asavartsov/daisybox/DaisyBoard/DaisyInterconnect/DaisyInterconnect.step

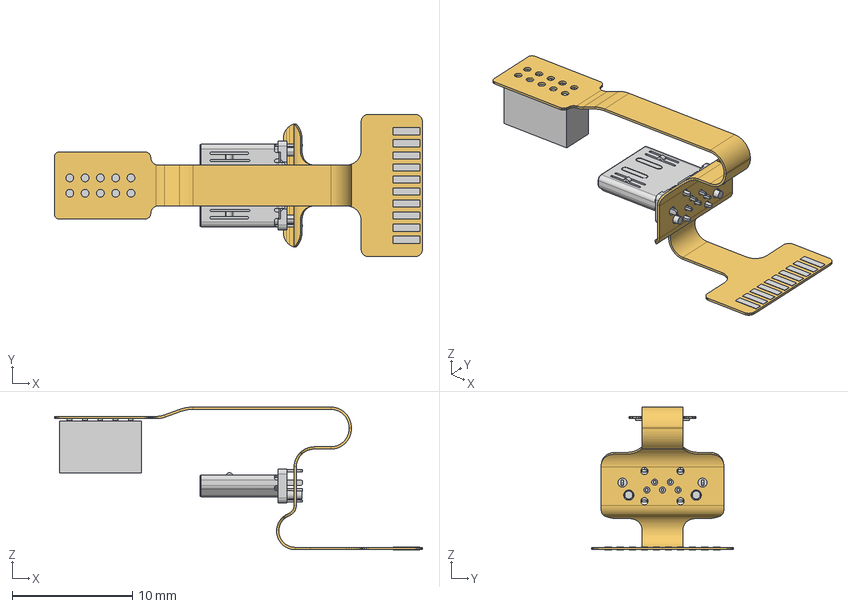
[picture p1: CAD file, 2023-12-05]
DaisyBoard/DaisyInterconnect/DaisyInterconnect.step
30.6 x 11.8 x 11.9 mm
Flex PCB
USB Plug
2x5 Socket
Pads
