asavartsov/daisybox/DaisyBoard/DaisyInterconnect/DaisyInterconnectBent.step

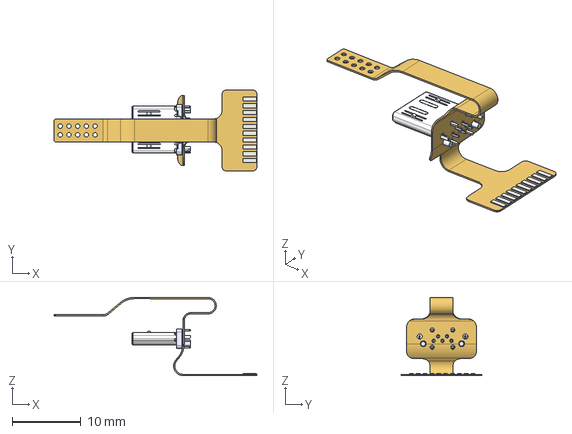
[picture p2: CAD file, 2023-12-05]
DaisyBoard/DaisyInterconnect/DaisyInterconnectBent.step
29.6 x 11.8 x 11.4 mm
_autosave-DaisyInterconnect PCB
