asavartsov/daisybox/DaisyBoard/DaisyInterconnect/DaisyInterconnectFlat.step

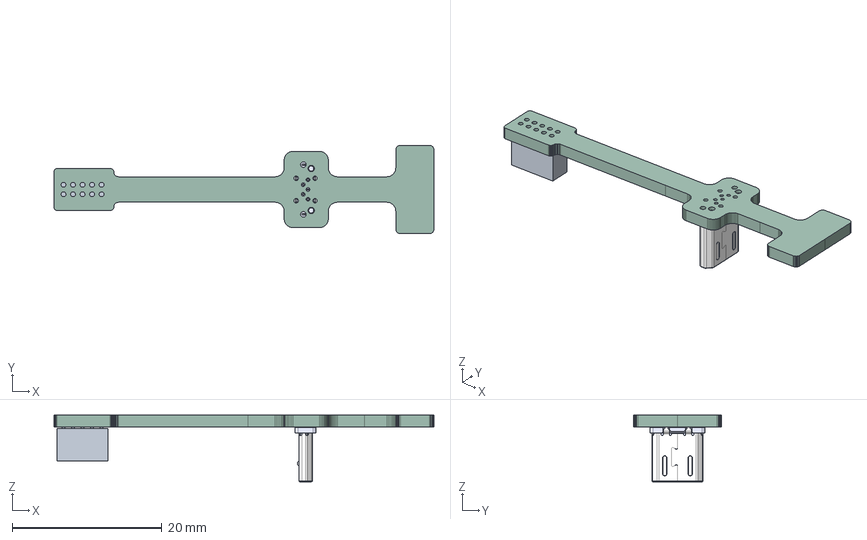
[picture p3: CAD file, 2023-12-05]
DaisyBoard/DaisyInterconnect/DaisyInterconnectFlat.step
50.7 x 11.8 x 8.88 mm
DaisyInterconnect PCB
