asavartsov/daisybox/Interconnect Flex Schematic.pdf

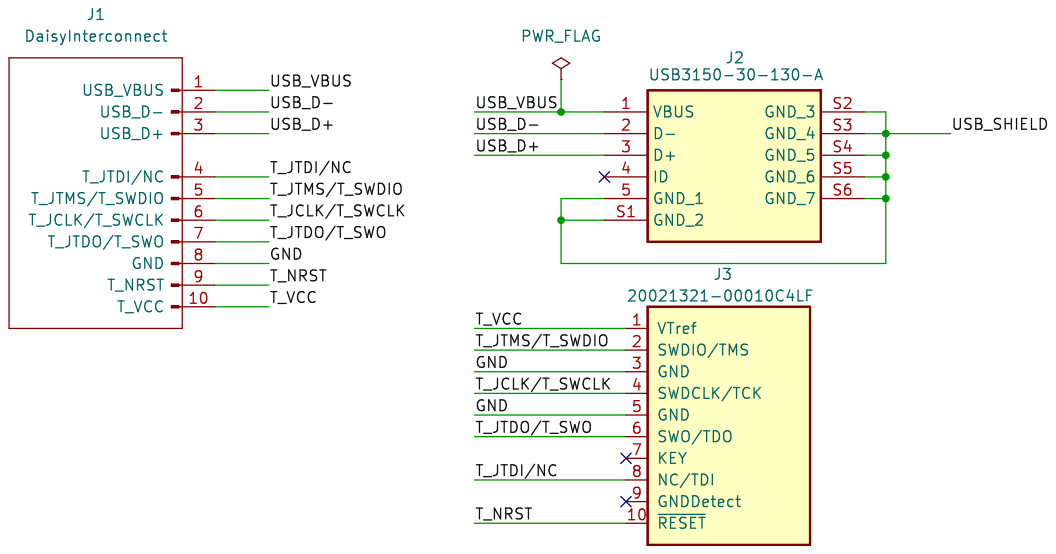
[picture p4: page 1]
