asavartsov/daisybox/Interconnect Flex PCB.pdf

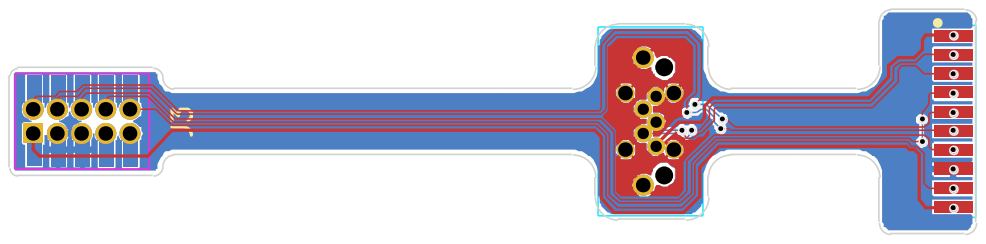
[picture p10: page 1]
