asavartsov/daisybox/PCB.pdf

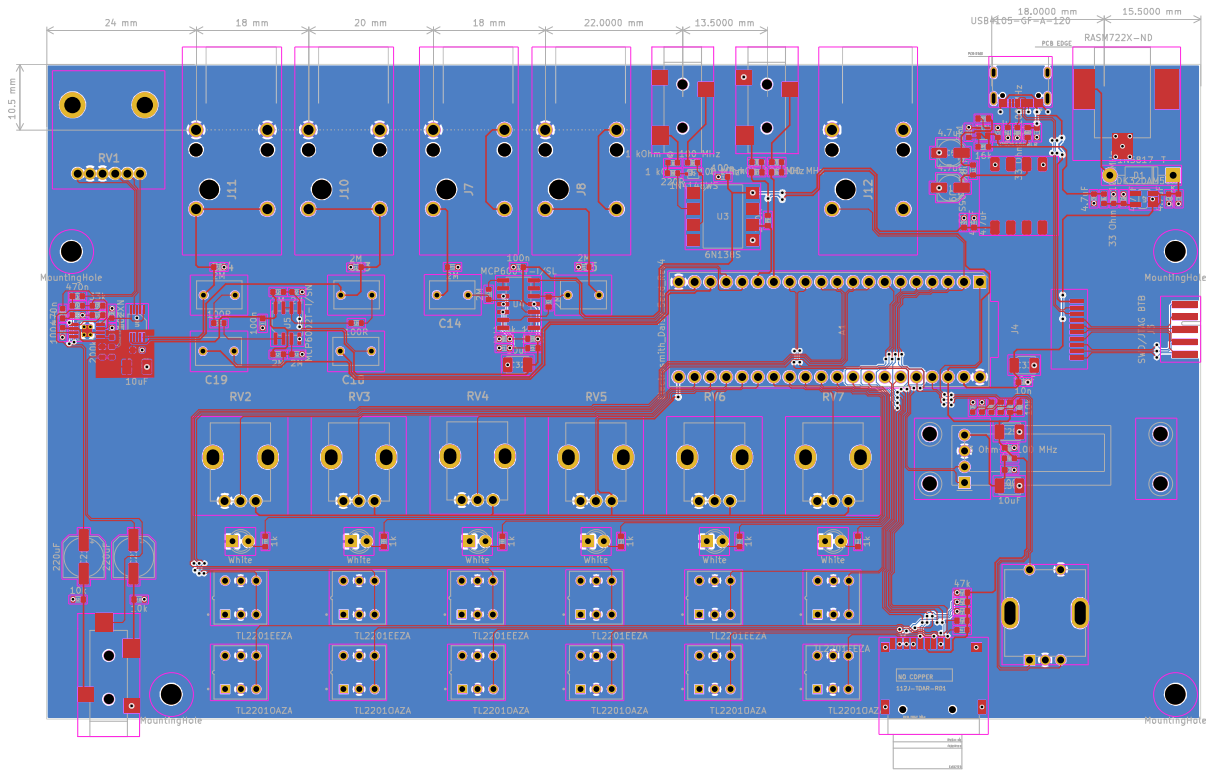
[picture p11: page 1]
