asavartsov/daisybox/DaisyBoard/DaisyInterconnect/DaisyInterconnect.kicad_pcb

## KiCad design DaisyBoard/DaisyInterconnect/DaisyInterconnect.kicad_pcb (2023-12-05)

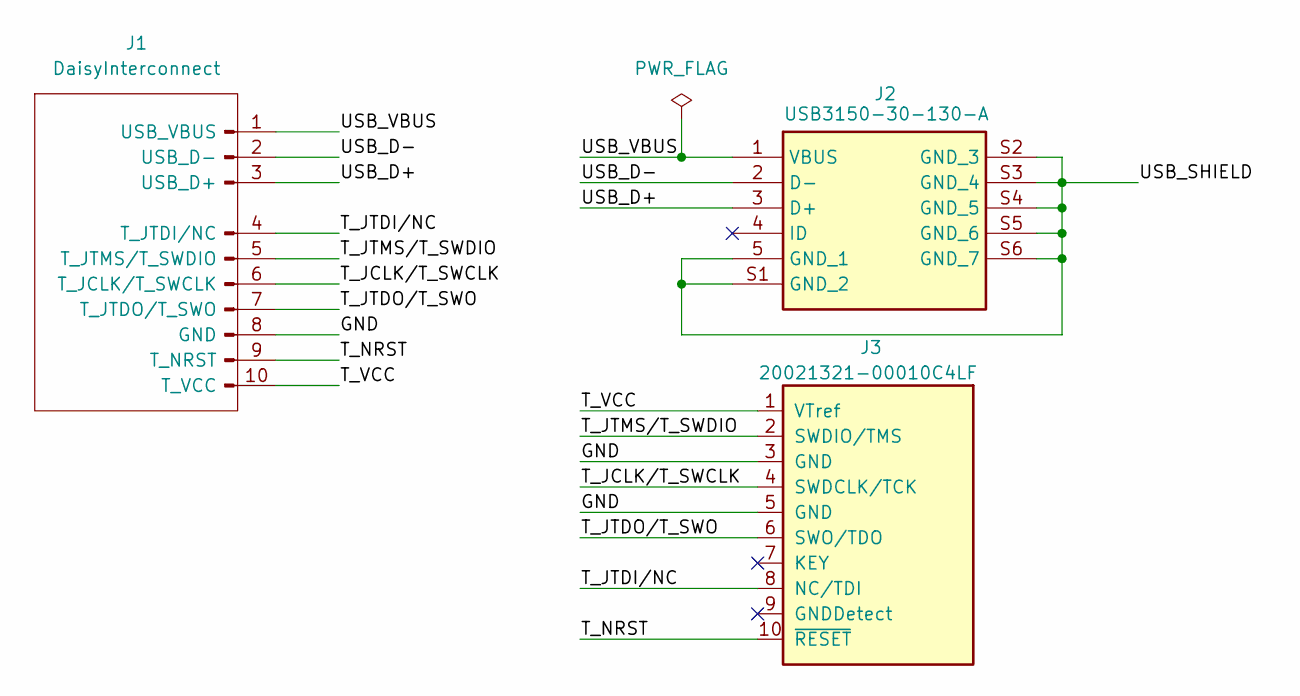
[picture p12: schematic DaisyInterconnect.kicad_sch]

Parts:
J1: DaisyInterconnect
J2: USB3150-30-130-A; USB315030130A; Manufacturer_Part_Number USB3150-30-130-A
J3: 20021321-00010C4LF; 2x05_P1.27mm; MPN 20021321-00010C4LF

Connections:
/GND: J1.8 (GND), J3.3 (GND), J3.5 (GND)
/T_JCLK/T_SWCLK: J1.6 (T_JCLK/T_SWCLK), J3.4 (SWDCLK/TCK)
/T_JTDI/NC: J1.4 (T_JTDI/NC), J3.8 (NC/TDI)
/T_JTDO/T_SWO: J1.7 (T_JTDO/T_SWO), J3.6 (SWO/TDO)
/T_JTMS/T_SWDIO: J1.5 (T_JTMS/T_SWDIO), J3.2 (SWDIO/TMS)
/T_NRST: J1.9 (T_NRST), J3.10 (~RESET)
/T_VCC: J1.10 (T_VCC), J3.1 (VTref)
/USB_D+: J1.3 (USB_D+), J2.3 (D+)
/USB_D-: J1.2 (USB_D-), J2.2 (D-)
/USB_SHIELD: J2.5 (GND_1), J2.S1 (GND_2), J2.S2 (GND_3), J2.S3 (GND_4), J2.S4 (GND_5), J2.S5 (GND_6), J2.S6 (GND_7)
/USB_VBUS: J1.1 (USB_VBUS), J2.1 (VBUS)

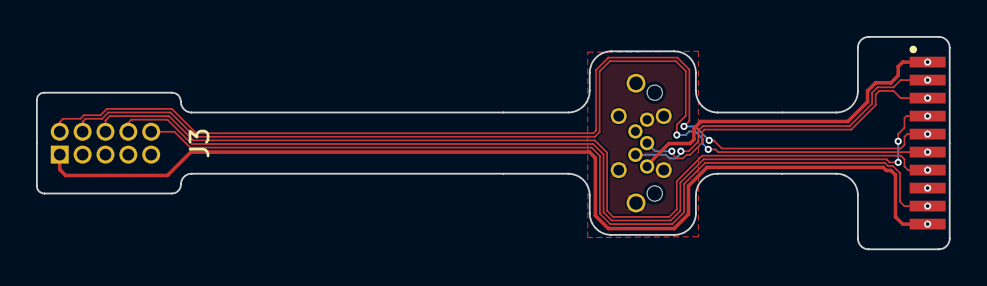
[picture p13: board DaisyInterconnect.kicad_pcb from above]

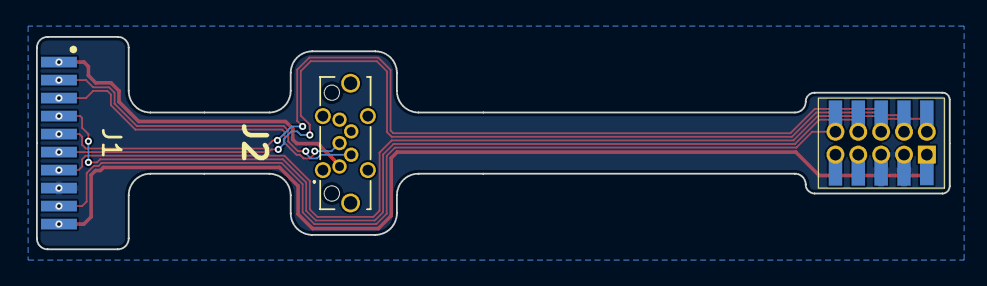
[picture p14: board DaisyInterconnect.kicad_pcb from below]

Board: 2 copper layers, 50.7 x 11.8 mm, 3 parts (2 on the bottom side), 11 nets.
