asavartsov/daisybox/DaisyBoard/DaisyBoard.kicad_pcb

## KiCad design DaisyBoard/DaisyBoard.kicad_pcb (2023-12-05)

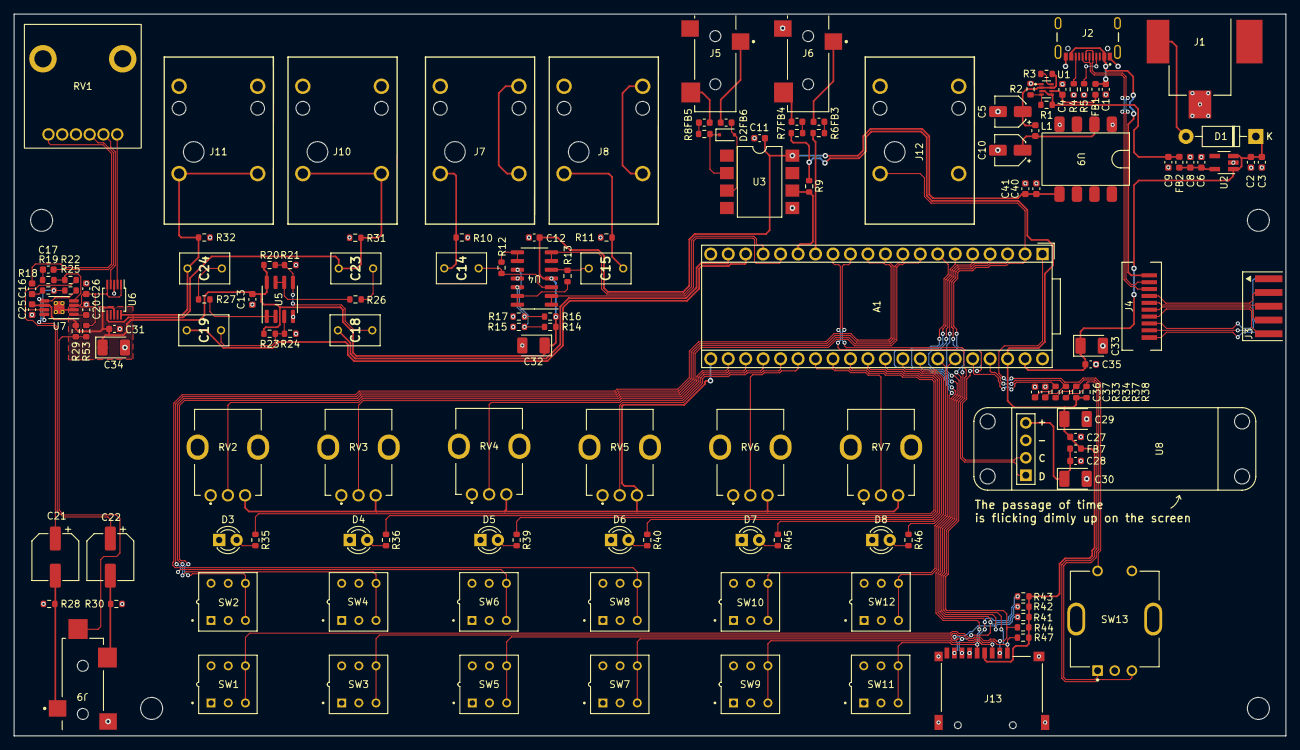
[picture p15: board DaisyBoard.kicad_pcb from above]

Board: 2 copper layers, 185.0 x 105.0 mm, 149 parts (0 on the bottom side), 111 nets.

Parts:
A1: Electrosmith_Daisy_Seed_Rev4; Electrosmith_Daisy_Seed
C1, C3, C8, C27, C35, C36, C37: 10n; C_0603_1608Metric
C2, C4, C6, C9, C40, C41: 4.7uF; C_0603_1608Metric
C5, C10: 4.7uF; CP_Elec_4x5.4
C11, C12, C13, C20, C25, C26, C28, C31: 100n; C_0603_1608Metric
C14, C15, C18, C19, C23, C24: 1uF; B32529C0105J189
C16, C17: 470n; C_0603_1608Metric
C21, C22: 220uF; CP_Elec_6.3x5.7
C29, C30, C32, C33, C34: 10uF; CP_EIA-3528-15_AVX-H_Pad1.50x2.35mm_HandSolder
D1: 1N5817-T; D_DO-41_SOD81_P10.16mm_Horizontal
D2: 1N4148WS; D_SOD-323F
D3, D4, D5, D6, D7, D8: White; QBL7IW60D-NW
FB1, FB2, FB7: 33 Ohm @ 100 MHz; L_0603_1608Metric
FB3, FB4, FB5, FB6: 1 kOhm @ 100 MHz; L_0603_1608Metric
H1, H2, H3, H4: MountingHole; MountingHole_3.2mm_M3
J1: RASM722X-ND; RASM722X
J2: USB4105-GF-A-120; GCT_USB4105GFA
J3: SWD/JTAG BTB; 009159010061916
J4: DaisyInterconnect
J5, J6: 35RASMT2BHNTRX
J7, J8, J10, J11, J12: ACJM-HHOP
J9: 35RASMT3BHNTRX
J13: 112J-TDAR-R01
L1: 6.8uH; L_0603_1608Metric
R1: 16k; R_0603_1608Metric
R2, R4, R5, R33, R34: 5k1; R_0603_1608Metric
R3, R28, R30, R37, R38: 10k; R_0603_1608Metric
R6: 10R; R_0603_1608Metric
R7: 33R; R_0603_1608Metric
R8: 220R; R_0603_1608Metric
R9: 270R; R_0603_1608Metric
R10, R11, R12, R13, R20, R21, R23, R24, R31, R32: 2M; R_0603_1608Metric
R14, R15, R16, R17: 100k; R_0603_1608Metric
R18, R19: 22k; R_0603_1608Metric
R22, R25, R53: 33k; R_0603_1608Metric
R26, R27: 100R; R_0603_1608Metric
R29: 200k; R_0603_1608Metric
R35, R36, R39, R40, R45, R46: 1k; R_0603_1608Metric
R41, R42, R43, R44, R47: 47k; R_0603_1608Metric
RV1: A50K; PTV112-4420A-A503
RV2, RV3, RV4, RV5, RV6, RV7: B10K; PTV09A-4025F-B103
SW1, SW3, SW5, SW7, SW9, SW11: TL2201OAZA; SW_TL2201EEZA
SW2, SW4, SW6, SW8, SW10, SW12: TL2201EEZA; SW_TL2201EEZA
SW13: PEC11H-4120F-S0020
U1: TPS2116DRLR; SOTFL50P160X60-8N
U2: LDK320AM50R; SOT-23-5_HandSoldering
U3: 6N138S; SMDIP-8_W9.53mm
U4: MCP6004T-I/SL; SOIC-14_3.9x8.7mm_P1.27mm
U5: MCP6002T-I/SN; SOIC-8_3.9x4.9mm_P1.27mm
U6: RS2102XN; MSOP-10_3x3mm_P0.5mm
U7: TPA6110A2DGN
U8: DFR0647
U9: IFS0105S05

Connections:
+3.3V: A1.38 (3V3_D), C27.1, C29.1, FB7.1, J13.4 (VDD), R7.2, R9.1, R37.1, R38.1, R41.1, R42.1, R43.1, R44.1, R47.1
+3.3VA: A1.21 (3V3_A), RV2.3, RV3.3, RV4.3, RV5.3, RV6.3, RV7.3
+3.3V_OLED: C28.1, C30.1, FB7.2, U8.4 (VCC)
+5V: C11.1, C12.1, C13.1, C25.1, C31.1, C32.1, C34.1, C40.1, C41.1, R14.1, R16.1, R20.1, R23.1, R29.1, U3.8 (VCC), U4.4 (V+), U5.8 (V+), U6.8 (VDD), U7.6 (VDD), U9.5 (+Vout)
+5V_DC: C9.1, FB2.2, R1.2, U1.3 (VIN1), U1.5 (MODE)
+5V_USB: C4.1, FB1.2, U1.6 (VIN2)
+9V: A1.39 (VIN), C2.1, C3.1, C33.1, C35.1, D1.1 (K), U2.1 (IN), U2.3 (EN)
/AnalogIO/HP_OUT_L: C21.2, J9.T, R28.1
/AnalogIO/HP_OUT_R: C22.2, J9.R, R30.1
/AnalogIO/L_IN_BIAS: R12.1, U4.8, U4.9 (-)
/AnalogIO/R_IN_BIAS: R13.1, U4.13 (-), U4.14
/DigitalIO/MIDI_IN_D1: FB5.1, J5.R
/DigitalIO/MIDI_IN_D2: FB6.1, J5.T
/DigitalIO/MIDI_OUT_D1: FB3.1, J6.T
/DigitalIO/MIDI_OUT_D2: FB4.1, J6.R
/Power/+5VMUX_LC_OUT: C10.1, L1.2, U9.2 (+Vin)
/Power/+5VMUX_OUT: C5.1, L1.1, R3.2, U1.2 (VOUT), U1.7 (VOUT)
/Power/+5V_DC_LDO: C6.1, C8.1, FB2.1, U2.5 (OUT)
/Power/+9V_DC_IN: D1.2 (A), J1.SLEEVE
AUDIO_L_IN: A1.16 (AUDIO_IN_1), U4.1, U4.2 (-)
AUDIO_L_OUT: A1.18 (AUDIO_OUT_1), C19.1
AUDIO_R_IN: A1.17 (AUDIO_IN_2), U4.6 (-), U4.7
AUDIO_R_OUT: A1.19 (AUDIO_OUT_2), C18.1
ENC_A: A1.36 (USB_D_-), C36.1, R33.2
ENC_B: A1.37 (USB_D_+), C37.1, R34.2
ENC_CLICK: A1.1 (USB_ID), SW13.S1
GND: A1.20 (AGND), A1.40 (DGND), C1.2, C2.2, C3.2, C4.2, C5.2, C6.2, C8.2, C9.2, C10.2, C11.2, C12.2, C13.2, C20.2, C25.2, C26.1, C27.2, C28.2, C29.2, C30.2, C31.2, C32.2, C33.2, C34.2, C35.2, C36.2, C37.2, C40.2, C41.2, D3.1 (K), D4.1 (K), D5.1 (K), D6.1 (K), D7.1 (K), D8.1 (K), J1.TIP, J2.A1_B12 (GND), J2.B1_A12 (GND), J6.S, J7.S, J8.S, J9.S, J10.S, J10.SN, J11.S, J11.SN, J12.S, J13.6 (VSS), J13.10 (SHIELD), R2.1, R4.1, R5.1, R10.2, R11.2, R15.2, R17.2, R21.2, R24.2, R28.2, R30.2, R31.2, R32.2, RV1.1, RV1.1*, RV2.1, RV3.1, RV4.1, RV5.1, RV6.1, RV7.1, SW1.2 (B), SW1.5 (B), SW2.2 (B), SW2.5 (B), SW3.2 (B), SW3.5 (B), SW4.2 (B), SW4.5 (B), SW5.2 (B), SW5.5 (B), SW6.2 (B), SW6.5 (B), SW7.2 (B), SW7.5 (B), SW8.2 (B), SW8.5 (B), SW9.2 (B), SW9.5 (B), SW10.2 (B), SW10.5 (B), SW11.2 (B), SW11.5 (B), SW12.2 (B), SW12.5 (B), SW13.C, SW13.S2, U1.1 (GND), U2.2 (GND), U3.5 (GND), U4.11 (V-), U5.4 (V-), U6.3 (GND), U7.2 (GND), U7.9 (GND), U8.3 (GND), U9.1 (-Vin), U9.4 (-Vout)
HP_DETECT: C26.2, R53.1, U6.1 (IN1), U6.5 (IN2), U7.3 (SHDN)
HP_VOL_L: RV1.3, U6.2 (S1B)
HP_VOL_R: RV1.3*, U6.4 (S2B)
LED_1: A1.28 (ADC_6), R35.2
LED_2: A1.29 (DAC_OUT2), R36.2
LED_3: A1.30 (DAC_OUT1), R39.2
LED_4: A1.31 (SAI2_MCLK), R40.2
LED_5: A1.32 (SAI2_SD_B), R45.2
LED_6: A1.33 (SAI2_SD_A), R46.2
MAIN_IN_L: C14.1, J7.T, R10.1
MAIN_IN_R: C15.1, J8.T, R11.1
MAIN_OUT_L: C24.2, J11.T, J11.TN, R32.1, U6.10 (D1)
MAIN_OUT_R: C23.2, J10.T, J10.TN, R31.1, U6.6 (D2)
MIDI_IN: A1.15 (USART1_RX), R9.2, U3.6 (VO2)
MIDI_OUT: A1.14 (USART1_TX), R6.2
unnamed: C16.1, RV1.2
unnamed: C16.2, R18.2
unnamed: C17.1, RV1.2*
unnamed: C17.2, R19.2
unnamed: C23.1, R26.2
unnamed: C24.1, R27.2
unnamed: D2.2 (A), FB6.2, U3.3 (C2)
unnamed: D2.1 (K), R8.2, U3.2 (C1)
unnamed: D3.2 (A), R35.1
unnamed: D4.2 (A), R36.1
unnamed: D5.2 (A), R39.1
unnamed: D6.2 (A), R40.1
unnamed: D7.2 (A), R45.1
unnamed: D8.2 (A), R46.1
unnamed: FB3.2, R6.1
unnamed: FB4.2, R7.1
unnamed: FB5.2, R8.1
unnamed: J2.A5 (CC1), R5.2
unnamed: J2.B5 (CC2), R4.2
unnamed: J3.6 (GND), J4.8 (GND)
unnamed: J3.4 (T_JCLK/T_SWCLK), J4.6 (T_JCLK/T_SWCLK)
unnamed: J3.2 (T_JTDI/NC), J4.4 (T_JTDI/NC)
unnamed: J3.5 (T_JTDO/T_SWO), J4.7 (T_JTDO/T_SWO)
unnamed: J3.3 (T_JTMS/T_SWDIO), J4.5 (T_JTMS/T_SWDIO)
unnamed: J3.9 (T_NRST), J4.9 (T_NRST)
unnamed: J3.10 (T_VCC), J4.10 (T_VCC)
unnamed: J7.SN, J7.TN
unnamed: J8.SN, J8.TN
unnamed: J9.TN, R29.2, R53.2
unnamed: R33.1, R37.2, SW13.A
unnamed: R34.1, R38.2, SW13.B
unnamed: R1.1, R2.2, U1.4 (PR1)
unnamed: R3.1, U1.8 (ST)
unnamed: C14.2, R12.2, U4.3 (+)
unnamed: C15.2, R13.2, U4.5 (+)
unnamed: R14.2, R15.1, U4.10 (+)
unnamed: R16.2, R17.1, U4.12 (+)
unnamed: C19.2, R23.2, R24.1, U5.3 (+)
unnamed: R27.1, U5.1, U5.2 (-)
unnamed: C18.2, R20.2, R21.1, U5.5 (+)
unnamed: R26.1, U5.6 (-), U5.7
unnamed: C20.1, U7.1 (BYPASS)
unnamed: R18.1, R25.2, U7.8 (IN1-)
unnamed: R19.1, R22.2, U7.4 (IN2-)
unnamed: C21.1, R22.1, U7.7 (VO1)
unnamed: C22.1, R25.1, U7.5 (VO2)
OLED_SCL: A1.12 (I2C1_SCL), U8.2 (SCL)
OLED_SDA: A1.13 (I2C1_SDA), U8.1 (SDA)
POT_1: A1.22 (ADC_0), RV2.2
POT_2: A1.23 (ADC_1), RV3.2
POT_3: A1.24 (ADC_2), RV4.2
POT_4: A1.25 (ADC_3), RV5.2
POT_5: A1.26 (ADC_4), RV6.2
POT_6: A1.27 (ADC_5), RV7.2
PUSH_1: A1.2 (SD_DATA_3), J12.T, J13.2 (DAT3/CD), R44.2, SW1.3 (C), SW1.6 (C)
PUSH_2: A1.3 (SD_DATA_2), J13.1 (DAT2), R47.2, SW3.3 (C), SW3.6 (C)
PUSH_3: A1.4 (SD_DATA_1), J13.8 (DAT1), R41.2, SW5.3 (C), SW5.6 (C)
PUSH_4: A1.5 (SD_DATA_0), J13.7 (DAT0), R42.2, SW7.3 (C), SW7.6 (C)
PUSH_5: A1.6 (SD_CMD), J13.3 (CMD), R43.2, SW9.3 (C), SW9.6 (C)
PUSH_6: A1.7 (SD_CLK), J13.5 (CLK), SW11.3 (C), SW11.6 (C)
SW_1: A1.8 (SPI1_CS), SW2.3 (C), SW2.6 (C)
SW_2: A1.9 (SPI1_SCK), SW4.3 (C), SW4.6 (C)
SW_3: A1.10 (SPI1_POCI), SW6.3 (C), SW6.6 (C)
SW_4: A1.11 (SPI1_PICO), SW8.3 (C), SW8.6 (C)
SW_5: A1.34 (SAI2_FS), SW10.3 (C), SW10.6 (C)
SW_6: A1.35 (SAI2_SCK), SW12.3 (C), SW12.6 (C)
USB_D+: J2.A6 (D+), J2.B6 (D+), J4.3 (USB_D+)
USB_D-: J2.A7 (D-), J2.B7 (D-), J4.2 (USB_D-)
USB_VBUS: C1.1, FB1.1, J2.A4_B9 (VBUS), J2.B4_A9 (VBUS), J4.1 (USB_VBUS)
